Reefwing-Software/NFC-Business-Card/artwork/Reefwing_Software-restored.png

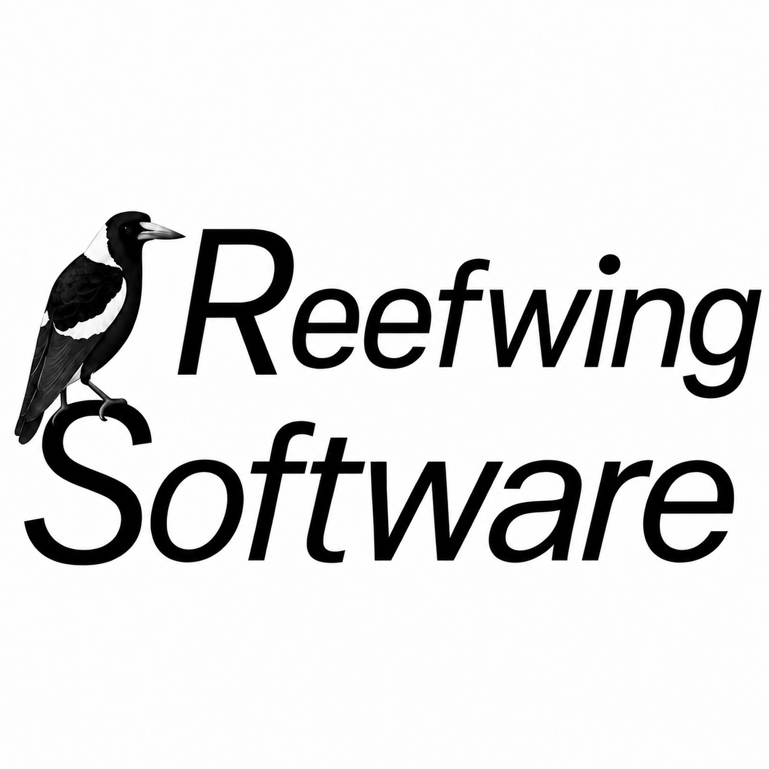
artwork/Reefwing_Software-restored.png
