Reefwing-Software/NFC-Business-Card/artwork/Reefwing_Studios-restored.png

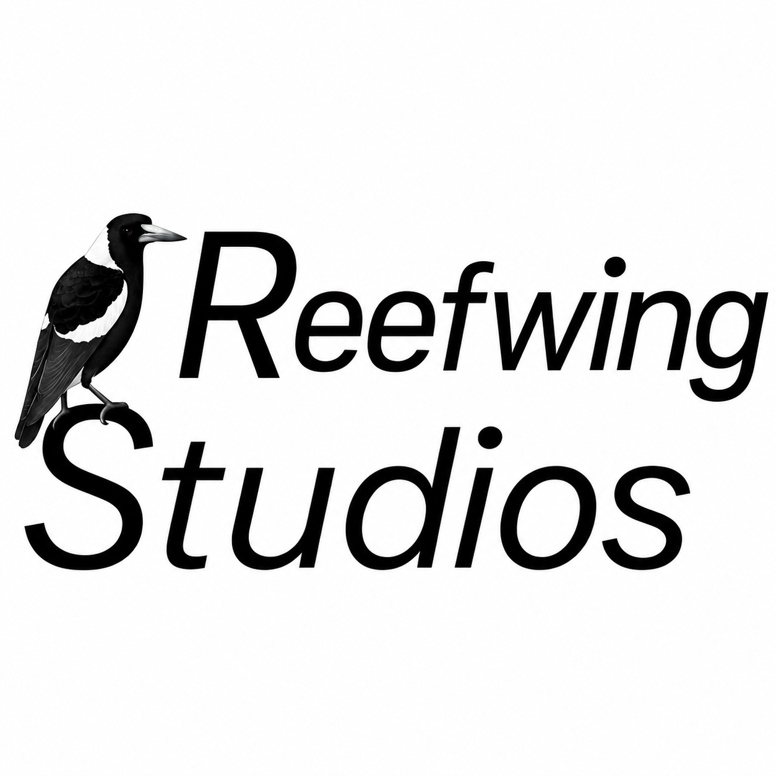
artwork/Reefwing_Studios-restored.png
