Reefwing-Software/NFC-Business-Card/artwork/Reefwing_Studios.png

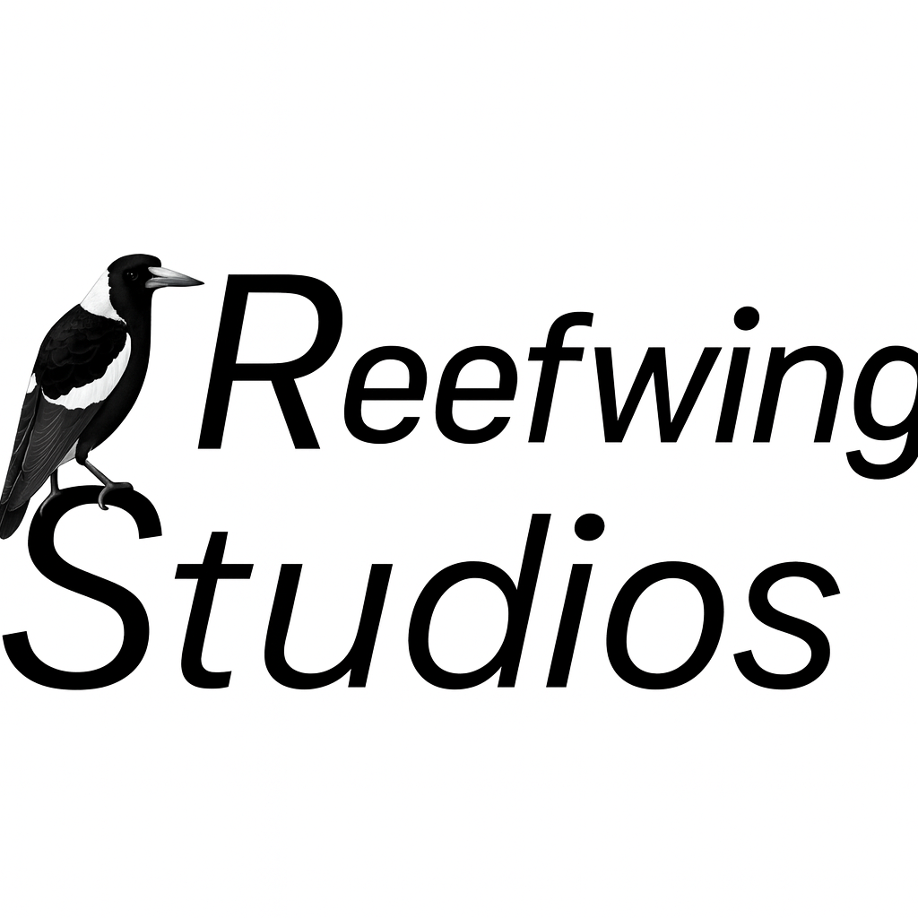
artwork/Reefwing_Studios.png
