Reefwing-Software/NFC-Business-Card/artwork/silkscreen-preview.png

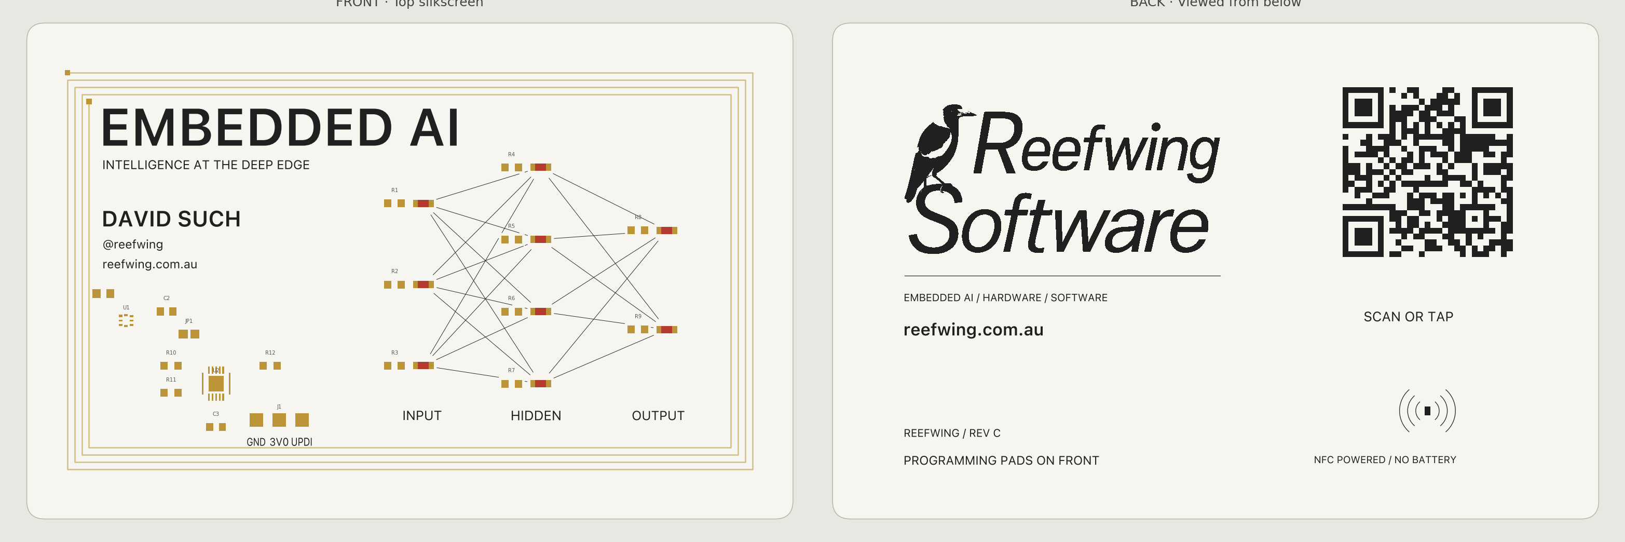
artwork/silkscreen-preview.png
