Reefwing-Software/NFC-Business-Card/(list of files, drawings)

Other design files:
revisions/rev-d/pcb-clearance-report.json
revisions/rev-d/pcb-connectivity-report.json
