Reefwing-Software/NFC-Business-Card/(commit log)

2026-09-12 Add Rev C NFC business card prototype design and documentation
2026-09-12 Remove mobile number from PCB silkscreen; verify homepage QR
2026-09-19 Fix cropped Reefwing logo and smooth bottom silkscreen artwork
2026-09-19 Use supplied Reefwing Studios PNG for bottom silkscreen
2026-09-19 Apply approved restored logo to bottom PCB silkscreen
2026-09-19 Use Reefwing Software variant of restored logo on PCB
2026-09-19 Add low-power ATtiny816 Arduino animation and UPDI upload guide
2026-09-19 Add ATtiny816 and NTAG I2C Plus datasheets
2026-09-28 Add simple sequential LED diagnostic sketch
2026-09-28 Design Rev D with corrected LED polarity, rounded corners and test pads
    [pcb-clearance-report.json, pcb-connectivity-report.json]
2026-09-30 Reduce Rev D test access to 3V and GND pads left of programming header
2026-10-01 Use supplied component symbols and linked footprints in Rev D
2026-10-05 Record EasyEDA PCB lessons and guidance for future project chats
