Reefwing-Software/NFC-Business-Card/(notices)

Notices in the files:
README.md:
License: MIT
